Mechbits-UK/keyboards/pcb/mb40/RP2040_keyboard.kicad_pcb

## KiCad design pcb/mb40/RP2040_keyboard.kicad_pcb (2022-09-19)

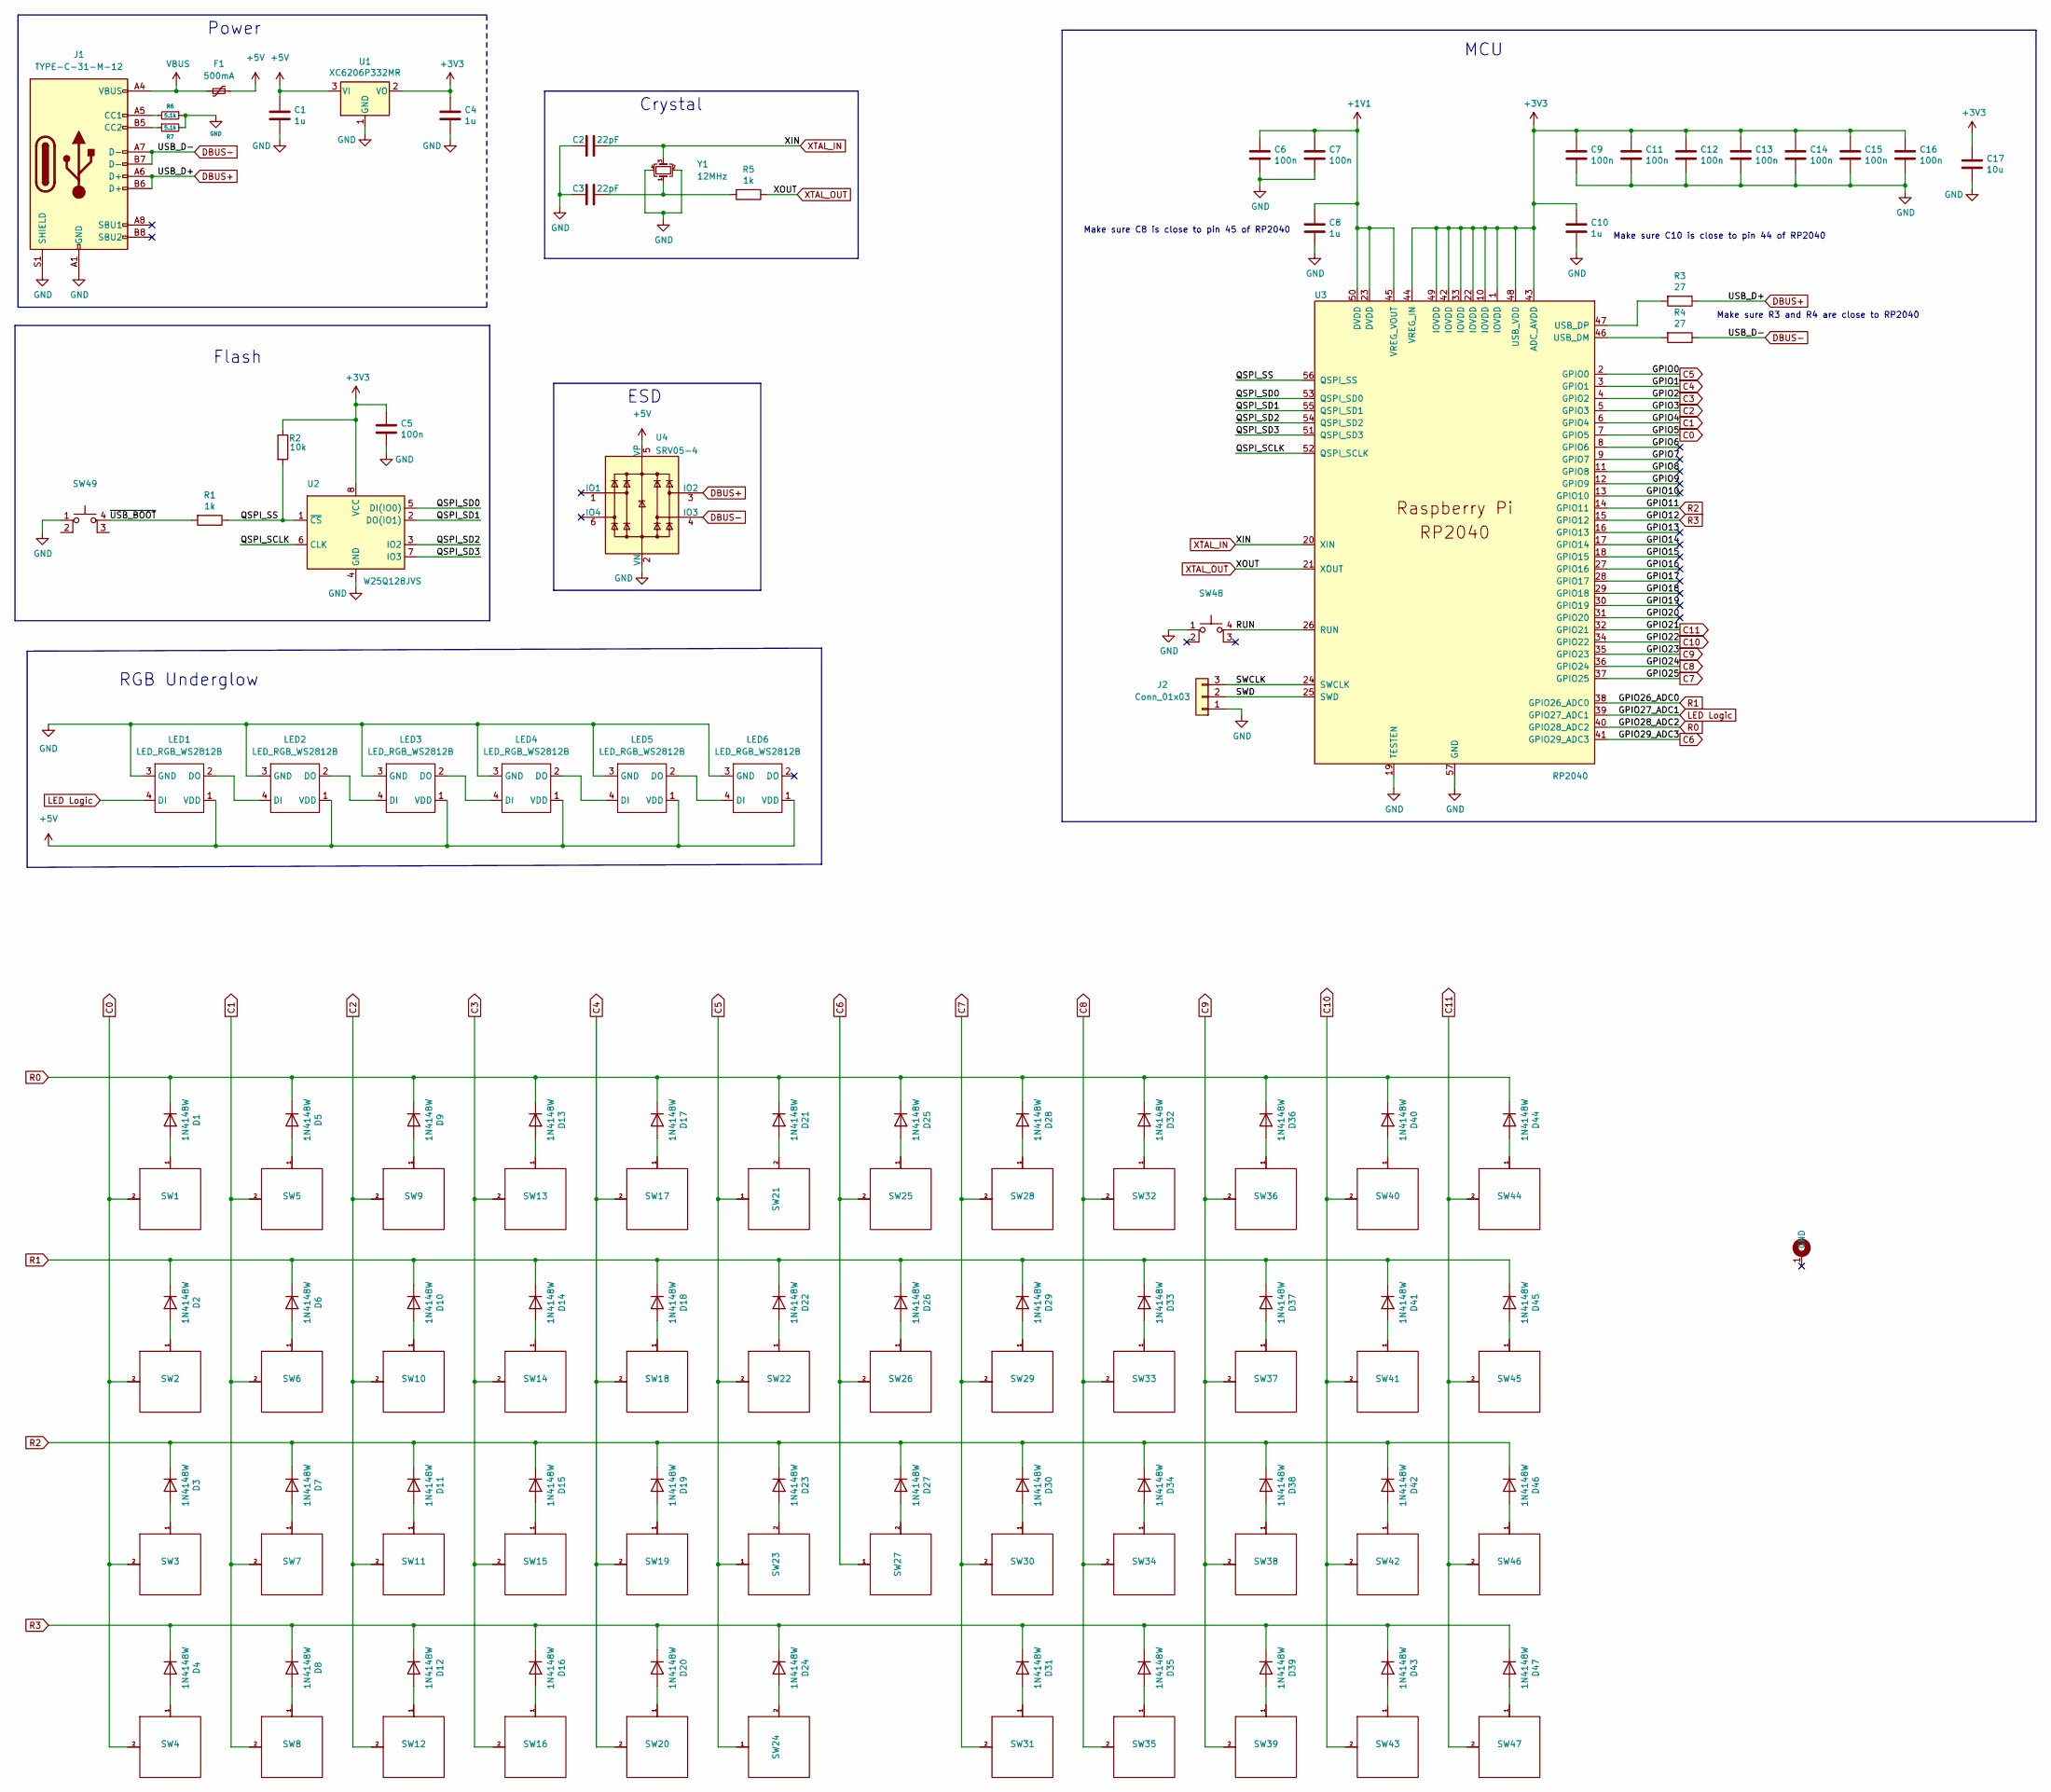
[picture p1: schematic RP2040_keyboard.kicad_sch, RP2040 Minimal Design Example]

Parts:
C1, C4, C8, C10: 1u; C_0402_1005Metric; LCSC C52923
C2, C3: 22pF; C_0402_1005Metric; LCSC C1555
C5, C6, C7, C9, C11, C12, C13, C14, C15, C16: 100n; C_0402_1005Metric; LCSC C1525
C17: 10u; C_0402_1005Metric; LCSC C15525
D1, D2, D3, D4, D5, D6, D7, D8, D9, D10, D11, D12, D13, D14, D15, D16, D17, D18, D19, D20, D21, D22, D23, D24, D25, D26, D27, D28, D29, D30, D31, D32, D33, D34, D35, D36, D37, D38, D39, D40, D41, D42, D43, D44, D45, D46, D47: 1N4148W; D_SOD-123; Manufacturer Part Number 1N4148W; LCSC C81598
F1: 500mA; Fuse_1206_3216Metric; LCSC C70076
H1: MountingHole-KB40; 40_pcb_mounting_holes
J1: TYPE-C-31-M-12; USB_C_Receptacle_Hroparts_TYPE-C-31-M-12; LCSC C165948
J2: Conn_01x03; PinHeader_1x03_P2.54mm_Vertical
LED1, LED2, LED3, LED4, LED5, LED6: LED_RGB_WS2812B; LED_WS2812B_PLCC4_5.0x5.0mm_P3.2mm; LCSC C2761795
R1, R5: 1k; C_0402_1005Metric; LCSC C11702
R2: 10k; C_0402_1005Metric; LCSC C25741
R3, R4: 27; C_0603_1608Metric; LCSC C25190
R6, R7: 5.1k; R_0402_1005Metric; Manufacturer Part Number 0402WGF5101TCE; LCSC C25905
SW1, SW2, SW3, SW4, SW5, SW6, SW7, SW8, SW9, SW10, SW11, SW12, SW13, SW14, SW15, SW16, SW17, SW18, SW19, SW20, SW21, SW22, SW23, SW25, SW26, SW27, SW28, SW29, SW30, SW31, SW32, SW33, SW34, SW35, SW36, SW37, SW38, SW39, SW40, SW41, SW42, SW43, SW44, SW45, SW46, SW47: MX Switch; MX100H-alt; LCSC C2803348
SW24: MX Switch; MX200H-alt; LCSC C2803348
SW48, SW49: SW_MEC_5E; SMD-SW-4_5.1x5.1x1.5; LCSC C318884
U1: XC6206P332MR; SOT-23; LCSC C5446
U2: W25Q128JVS; SOIC-8_5.23x5.23mm_P1.27mm; LCSC C97521
U3: RP2040; RP2040-QFN-56; LCSC C2040
U4: SRV05-4; SOT-23-6; LCSC C85364
Y1: 12MHz; Crystal_SMD_3225-4Pin_3.2x2.5mm; LCSC C9002

Connections:
+1V1: C6.1, C7.1, C8.1, U3.23 (DVDD), U3.45 (VREG_VOUT), U3.50 (DVDD)
+3V3: C4.1, C5.1, C9.1, C10.1, C11.1, C12.1, C13.1, C14.1, C15.1, C16.1, C17.1, R2.1, U1.2 (VO), U2.8 (VCC), U3.1 (IOVDD), U3.10 (IOVDD), U3.22 (IOVDD), U3.33 (IOVDD), U3.42 (IOVDD), U3.43 (ADC_AVDD), U3.44 (VREG_IN), U3.48 (USB_VDD), U3.49 (IOVDD)
+5V: C1.1, F1.2, LED1.1 (VDD), LED2.1 (VDD), LED3.1 (VDD), LED4.1 (VDD), LED5.1 (VDD), LED6.1 (VDD), U1.3 (VI), U4.5 (VP)
/GPIO6: U3.8 (GPIO6)
/GPIO7: U3.9 (GPIO7)
/GPIO8: U3.11 (GPIO8)
/GPIO9: U3.12 (GPIO9)
/GPIO10: U3.13 (GPIO10)
/GPIO13: U3.16 (GPIO13)
/GPIO14: U3.17 (GPIO14)
/GPIO15: U3.18 (GPIO15)
/GPIO16: U3.27 (GPIO16)
/GPIO17: U3.28 (GPIO17)
/GPIO18: U3.29 (GPIO18)
/GPIO19: U3.30 (GPIO19)
/GPIO20: U3.31 (GPIO20)
/QSPI_SCLK: U2.6 (CLK), U3.52 (QSPI_SCLK)
/QSPI_SD0: U2.5 (DI(IO0)), U3.53 (QSPI_SD0)
/QSPI_SD1: U2.2 (DO(IO1)), U3.55 (QSPI_SD1)
/QSPI_SD2: U2.3 (IO2), U3.54 (QSPI_SD2)
/QSPI_SD3: U2.7 (IO3), U3.51 (QSPI_SD3)
/QSPI_SS: R1.1, R2.2, U2.1 (~CS), U3.56 (QSPI_SS)
/RUN: SW48.4 (A), U3.26 (RUN)
/SWCLK: J2.3, U3.24 (SWCLK)
/SWD: J2.2, U3.25 (SWD)
/~USB_BOOT: R1.2, SW49.4 (A)
C0: SW1.2, SW2.2, SW3.2, SW4.2, U3.7 (GPIO5)
C1: SW5.2, SW6.2, SW7.2, SW8.2, U3.6 (GPIO4)
C2: SW9.2, SW10.2, SW11.2, SW12.2, U3.5 (GPIO3)
C3: SW13.2, SW14.2, SW15.2, SW16.2, U3.4 (GPIO2)
C4: SW17.2, SW18.2, SW19.2, SW20.2, U3.3 (GPIO1)
C5: SW21.1, SW22.2, SW23.1, SW24.1, U3.2 (GPIO0)
C6: SW25.2, SW26.2, SW27.1, U3.41 (GPIO29_ADC3)
C7: SW28.2, SW29.2, SW30.2, SW31.2, U3.37 (GPIO25)
C8: SW32.2, SW33.2, SW34.2, SW35.2, U3.36 (GPIO24)
C9: SW36.2, SW37.2, SW38.2, SW39.2, U3.35 (GPIO23)
C10: SW40.2, SW41.2, SW42.2, SW43.2, U3.34 (GPIO22)
C11: SW44.2, SW45.2, SW46.2, SW47.2, U3.32 (GPIO21)
DBUS+: J1.A6 (D+), J1.B6 (D+), R3.1, U4.3 (IO2)
DBUS-: J1.A7 (D-), J1.B7 (D-), R4.1, U4.4 (IO3)
GND: C1.2, C2.2, C3.2, C4.2, C5.2, C6.2, C7.2, C8.2, C9.2, C10.2, C11.2, C12.2, C13.2, C14.2, C15.2, C16.2, C17.2, J1.A1 (GND), J1.B1 (GND), J1.S1 (SHIELD), J2.1, LED1.3 (GND), LED2.3 (GND), LED3.3 (GND), LED4.3 (GND), LED5.3 (GND), LED6.3 (GND), R6.1, R7.2, SW48.1, SW49.1, U1.1 (GND), U2.4 (GND), U3.19 (TESTEN), U3.57 (GND), U4.2 (VN), Y1.2, Y1.4
LED Logic: LED1.4 (DI), U3.39 (GPIO27_ADC1)
unnamed: C3.1, R5.2, Y1.1
unnamed: D1.2 (A), SW1.1
unnamed: D2.2 (A), SW2.1
unnamed: D3.2 (A), SW3.1
unnamed: D4.2 (A), SW4.1
unnamed: D5.2 (A), SW5.1
unnamed: D6.2 (A), SW6.1
unnamed: D7.2 (A), SW7.1
unnamed: D8.2 (A), SW8.1
unnamed: D9.2 (A), SW9.1
unnamed: D10.2 (A), SW10.1
unnamed: D11.2 (A), SW11.1
unnamed: D12.2 (A), SW12.1
unnamed: D13.2 (A), SW13.1
unnamed: D14.2 (A), SW14.1
unnamed: D15.2 (A), SW15.1
unnamed: D16.2 (A), SW16.1
unnamed: D17.2 (A), SW17.1
unnamed: D18.2 (A), SW18.1
unnamed: D19.2 (A), SW19.1
unnamed: D20.2 (A), SW20.1
unnamed: D21.2 (A), SW21.2
unnamed: D22.2 (A), SW22.1
unnamed: D23.2 (A), SW23.2
unnamed: D24.2 (A), SW24.2
unnamed: D25.2 (A), SW25.1
unnamed: D26.2 (A), SW26.1
unnamed: D27.2 (A), SW27.2
unnamed: D28.2 (A), SW28.1
unnamed: D29.2 (A), SW29.1
unnamed: D30.2 (A), SW30.1
unnamed: D31.2 (A), SW31.1
unnamed: D32.2 (A), SW32.1
unnamed: D33.2 (A), SW33.1
unnamed: D34.2 (A), SW34.1
unnamed: D35.2 (A), SW35.1
unnamed: D36.2 (A), SW36.1
unnamed: D37.2 (A), SW37.1
unnamed: D38.2 (A), SW38.1
unnamed: D39.2 (A), SW39.1
unnamed: D40.2 (A), SW40.1
unnamed: D41.2 (A), SW41.1
unnamed: D42.2 (A), SW42.1
unnamed: D43.2 (A), SW43.1
unnamed: D44.2 (A), SW44.1
unnamed: D45.2 (A), SW45.1
unnamed: D46.2 (A), SW46.1
unnamed: D47.2 (A), SW47.1
unnamed: J1.A5 (CC1), R6.2
unnamed: J1.B5 (CC2), R7.1
unnamed: LED1.2 (DO), LED2.4 (DI)
unnamed: LED2.2 (DO), LED3.4 (DI)
unnamed: LED3.2 (DO), LED4.4 (DI)
unnamed: LED4.2 (DO), LED5.4 (DI)
unnamed: LED5.2 (DO), LED6.4 (DI)
unnamed: R3.2, U3.47 (USB_DP)
unnamed: R4.2, U3.46 (USB_DM)
R0: D1.1 (K), D5.1 (K), D9.1 (K), D13.1 (K), D17.1 (K), D21.1 (K), D25.1 (K), D28.1 (K), D32.1 (K), D36.1 (K), D40.1 (K), D44.1 (K), U3.40 (GPIO28_ADC2)
R1: D2.1 (K), D6.1 (K), D10.1 (K), D14.1 (K), D18.1 (K), D22.1 (K), D26.1 (K), D29.1 (K), D33.1 (K), D37.1 (K), D41.1 (K), D45.1 (K), U3.38 (GPIO26_ADC0)
R2: D3.1 (K), D7.1 (K), D11.1 (K), D15.1 (K), D19.1 (K), D23.1 (K), D27.1 (K), D30.1 (K), D34.1 (K), D38.1 (K), D42.1 (K), D46.1 (K), U3.14 (GPIO11)
R3: D4.1 (K), D8.1 (K), D12.1 (K), D16.1 (K), D20.1 (K), D24.1 (K), D31.1 (K), D35.1 (K), D39.1 (K), D43.1 (K), D47.1 (K), U3.15 (GPIO12)
VBUS: F1.1, J1.A4 (VBUS), J1.B4 (VBUS)
XTAL_IN: C2.1, U3.20 (XIN), Y1.3
XTAL_OUT: R5.1, U3.21 (XOUT)

Notes on the sheet:
Power
Make sure R3 and R4 are close to RP2040
RGB Underglow
ESD
Make sure C8 is close to pin 45 of RP2040
MCU
Crystal
Flash
Make sure C10 is close to pin 44 of RP2040

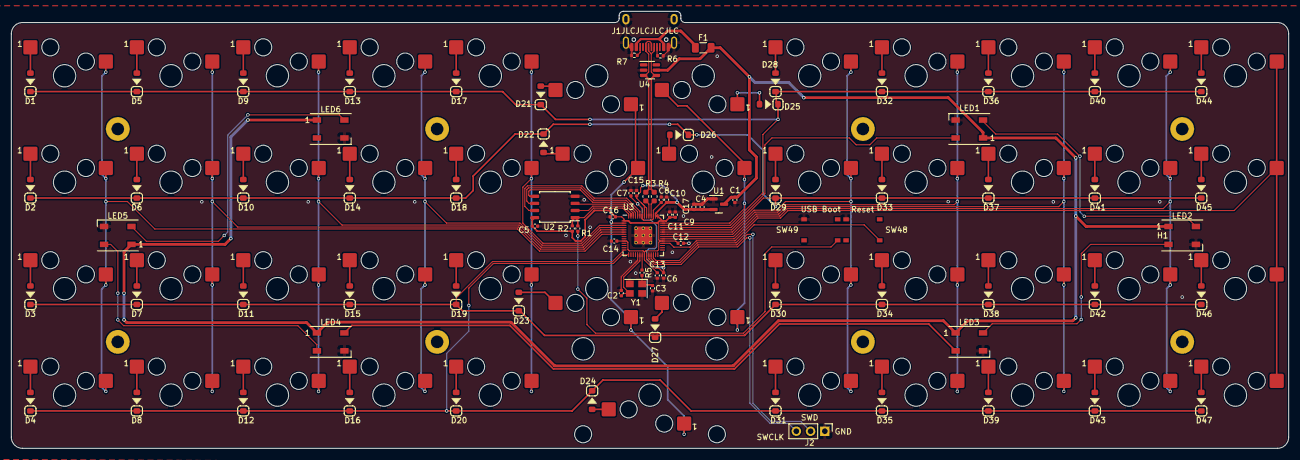
[picture p2: board RP2040_keyboard.kicad_pcb from above]

Board: 2 copper layers, 228.0 x 78.0 mm, 135 parts (0 on the bottom side), 93 nets.
